mbisbano1/ECE388_CatchTheLightV2/Photos/20201203_170117.jpg

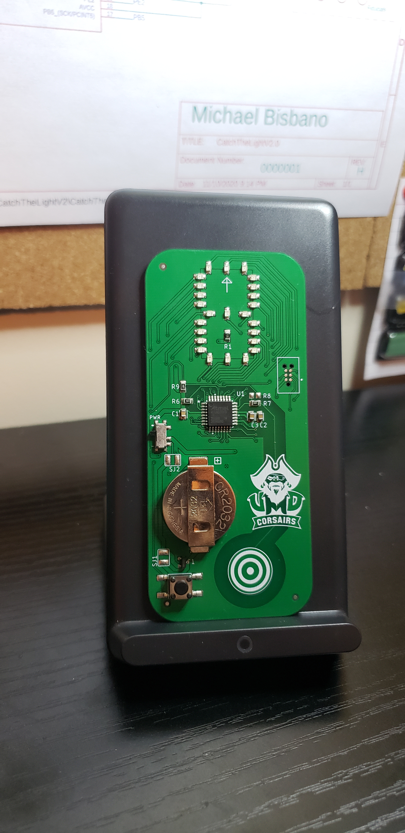
Photos/20201203_170117.jpg
