mbisbano1/ECE388_CatchTheLightV2/SilkscreenImages/umd.jpg

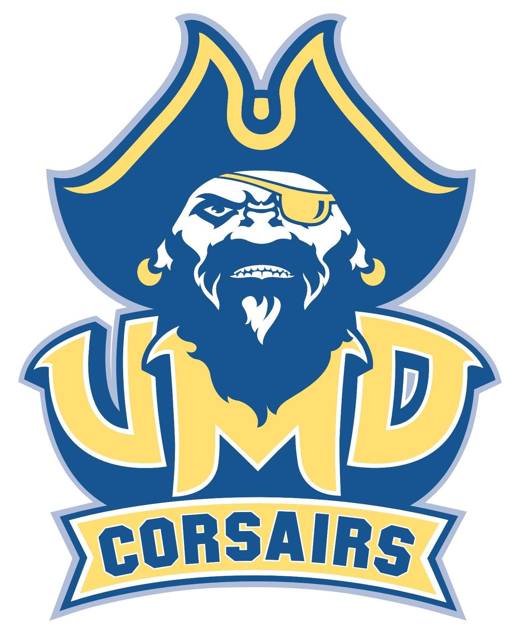
SilkscreenImages/umd.jpg
