mbisbano1/ECE388_CatchTheLightV2/README.md

# ECE388_CatchTheLightV2
Michael Bisbano's Fall 2020 ECE 388 Project: CatchTheLightV2
