mbisbano1/ECE388_CatchTheLightV2/(threads)

Thread 1 (2020-10-18):

Bom Review

timChase98, 2020-10-18:
- [x] Q-Touch button shouldn't be on the BOM
- [ ] battery holder should have the alt supplier colums filled out.

Good work, please fix these things but I'll put you down as passed.

mbisbano1, 2020-10-19:
For the price of the battery holder, I wasn't able to find it, and it isn't available on the link to it.
I have included the link to the battery holder on the BOM, but left the price blank.

I also removed the Q-touch button from the BOM as you recommended.

Closed 2020-11-07.

Thread 2 (2020-11-07):

Schematic Submission

timChase98, 2020-11-07:
- [x] While this is very organized its hard to follow.
  - [x] Try to have clear flow from left-right
  - [x] Power input top left
  - [x] Buttons input to uController
  - [x] uController outputs to LEDs
- [x] Do you have reverse voltage protection for if the user inserts a battery backwards?
- [x] Use power flags instead of named nets for power
- [x] Any time a signal leaves the section of the schematic that should be clearly indicated by a tail net. LED_ANODE is an example of this.  It should be clear that that is coming from somewhere else
- [x] The 328PB symbol doesn't need to be anywhere near that wide.
- [x] Decoupling capacitors should be located near the chip they are decoupling.  Ideally connected via a physical net, this makes it more clear what chip it belongs to when you go to do a layout.

Aside from format issue this looks really good.  Address the format issues but I will move onto board review.

Please address these issues and push your changes. Then create a new release, increment the tag and close this issue. I will review the changes and mark this as complete or reopen the issue with additional feedback.

mbisbano1, 2020-11-09:
I have tried to clear all issues posed here.

1. Added Schottky Diode Reverse voltage protection
2. Replaced net labels with Power Flags from supply1 library
3. Made Signals entering and exiting nets easier to follow by using bold label flags.
4. Narrowed the 328PB symbol..
5. Placed Decoupling capacitors physically closer to 328pb symbol to denote their proximity on board layout.
6. More organized left - right flow of information in schematic.

- Battery connection top left.
- Immediately below that is the reverse voltage protection and power switch
- Immediately below that is the current limiting resistor which 'produces' LED_ANODE voltage source.
- Flow of Button/Spare Button signal connection is more intuitive as well, which is directly connected to uController PE3 through a physical net.

NOTE:
- I left the LEDs along the top row and did not directly connect them to the 328pb symbol as the clutter from connecting all of those traces alongside with the decoupling caps would surely make the schematic unreadable.

timChase98, 2020-11-10:
Why are there resistors on the programming line? Its also called a bed of nails programmer not a plug of nails.  Fix those things and I'll give you a pass

mbisbano1, 2020-11-10:
Issues fixed as requested.

timChase98, 2020-11-11:
Change your reverse voltage protection to the one from [THIS](https://www.ti.com/lit/an/slva139/slva139.pdf) App note from TI.  That should be the last thing.

timChase98, 2020-11-11:
Yes the point of the app note is that just dropping a diode in isn't a great solution and using the NFet is much better

mbisbano1, 2020-11-11:
Schottky Diode reverse protection replaced with a PMOS protection circuit citing said app note. Reasoning for PMOS is PMOS are cheaper than NMOS by thin margin, and wiring is easier in my scenario.

Closed 2020-11-11.

Thread 3 (2020-11-07):

Board Submission

timChase98, 2020-11-07:
- [x] Review the submission guidelines [HERE](https://github.com/timChase98/388Example)
- [x] Silkscreen labels must include
  - [x] Your Name
  - [x] Project Name
  - [x] Date
  - [x] Version/Rev
  - [x] Github Link
- [x] Check stock sheet for correct footprints for
  - [x] Power Switch
  - [x] Battery Holder
- [x] Placement of fiducials should be
  - [x] FID1 lower left
  - [x] FID2 upper left
  - [x] FID3 lower right
- [x] Looks like the silkscreen for the battery holder goes over the pads.  I would also add thermal relief to the center pad-gnd plane

These are initial comments meant to guide you though the layout process.  I will not look at your board again until your schematic passes review.  This is to reduce the workload on you by limiting the number of times you need to relayout your board due to schematic errors.

Please address these issues and push your changes. Then create a new release, increment the tag and close this issue. I will review the changes and mark this as complete or reopen the issue with additional feedback.

mbisbano1, 2020-11-10:
Are you able to specify what about my submission went against the submission guidelines? I thought I followed them quite well.

timChase98, 2020-11-11:
Sorry you can ignore that.  Its from the template I used for everyone and I forgot to take it out for you

mbisbano1, 2020-11-11:
@timChase98 when/if you get a chance could you look at the footprint I made for the switch? Low priority as I have the bypass solder junction there as you recommended.

timChase98, 2020-11-11:
Is it in the current gerber files?

mbisbano1, 2020-11-11:
@timChase98 Yes, it was in the Gerber files. I was just concerned about the drills required.

timChase98, 2020-11-11:
Ya it looks good as far as I can tell

mbisbano1, 2020-11-11:
Okay, thank you.

timChase98, 2020-11-11:
You have a couple of spots where the silkscreen overlaps the pads The text SJ2 and your + and - symbols.  Everything else looks good.

mbisbano1, 2020-11-11:
Okay, I'll fix that quick. Thank you

timChase98, 2020-11-11:
Looks good.  Move onto layout

timChase98, 2020-11-11:
wrong tab ignore that

mbisbano1, 2020-11-11:
Okay, I'll fix that quick. Thank you

mbisbano1, 2020-11-11:
Issues fixed, and new Gerber Submission Release created.

timChase98, 2020-11-11:
Still an issue for T1 and SJ2 should be next to the jumper not the test points

mbisbano1, 2020-11-11:
Whoops. Thanks. I looked over every pad this time, should be good.

timChase98, 2020-11-11:
This passes, good job

mbisbano1, 2020-11-11:
Awesome, thank you

timChase98, 2020-11-16:
Your board was sent to fab

Closed 2020-11-11.
