mbisbano1/ECE388_CatchTheLightV2/schematic.pdf

A

A

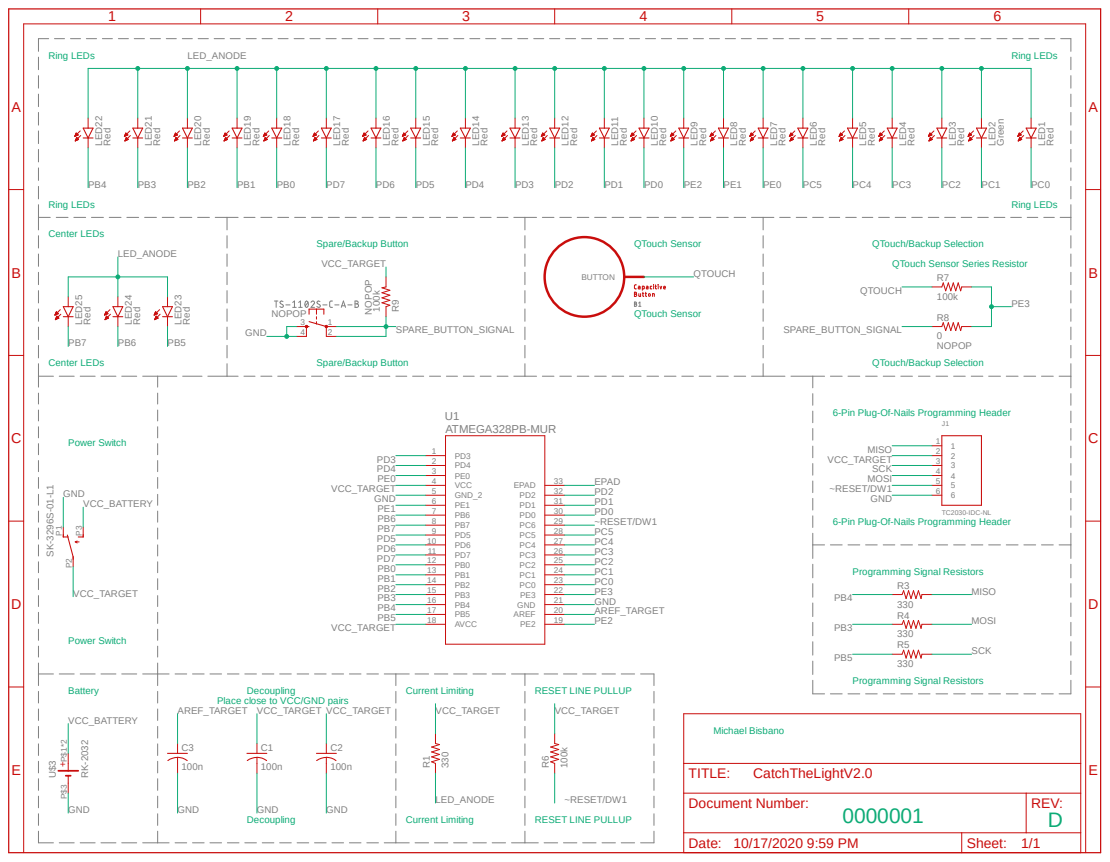
[picture p3: page 1]

LED_ANODE

QTouch/Backup Selection
QTouch Sensor Series Resistor

6-Pin Plug-Of-Nails Programming Header

Document Number: | REV:

Date: 10/17/2020 9:59 PM | Sheet: 1/1
