mbisbano1/ECE388_CatchTheLightV2/CatchTheLightV2.0.pdf

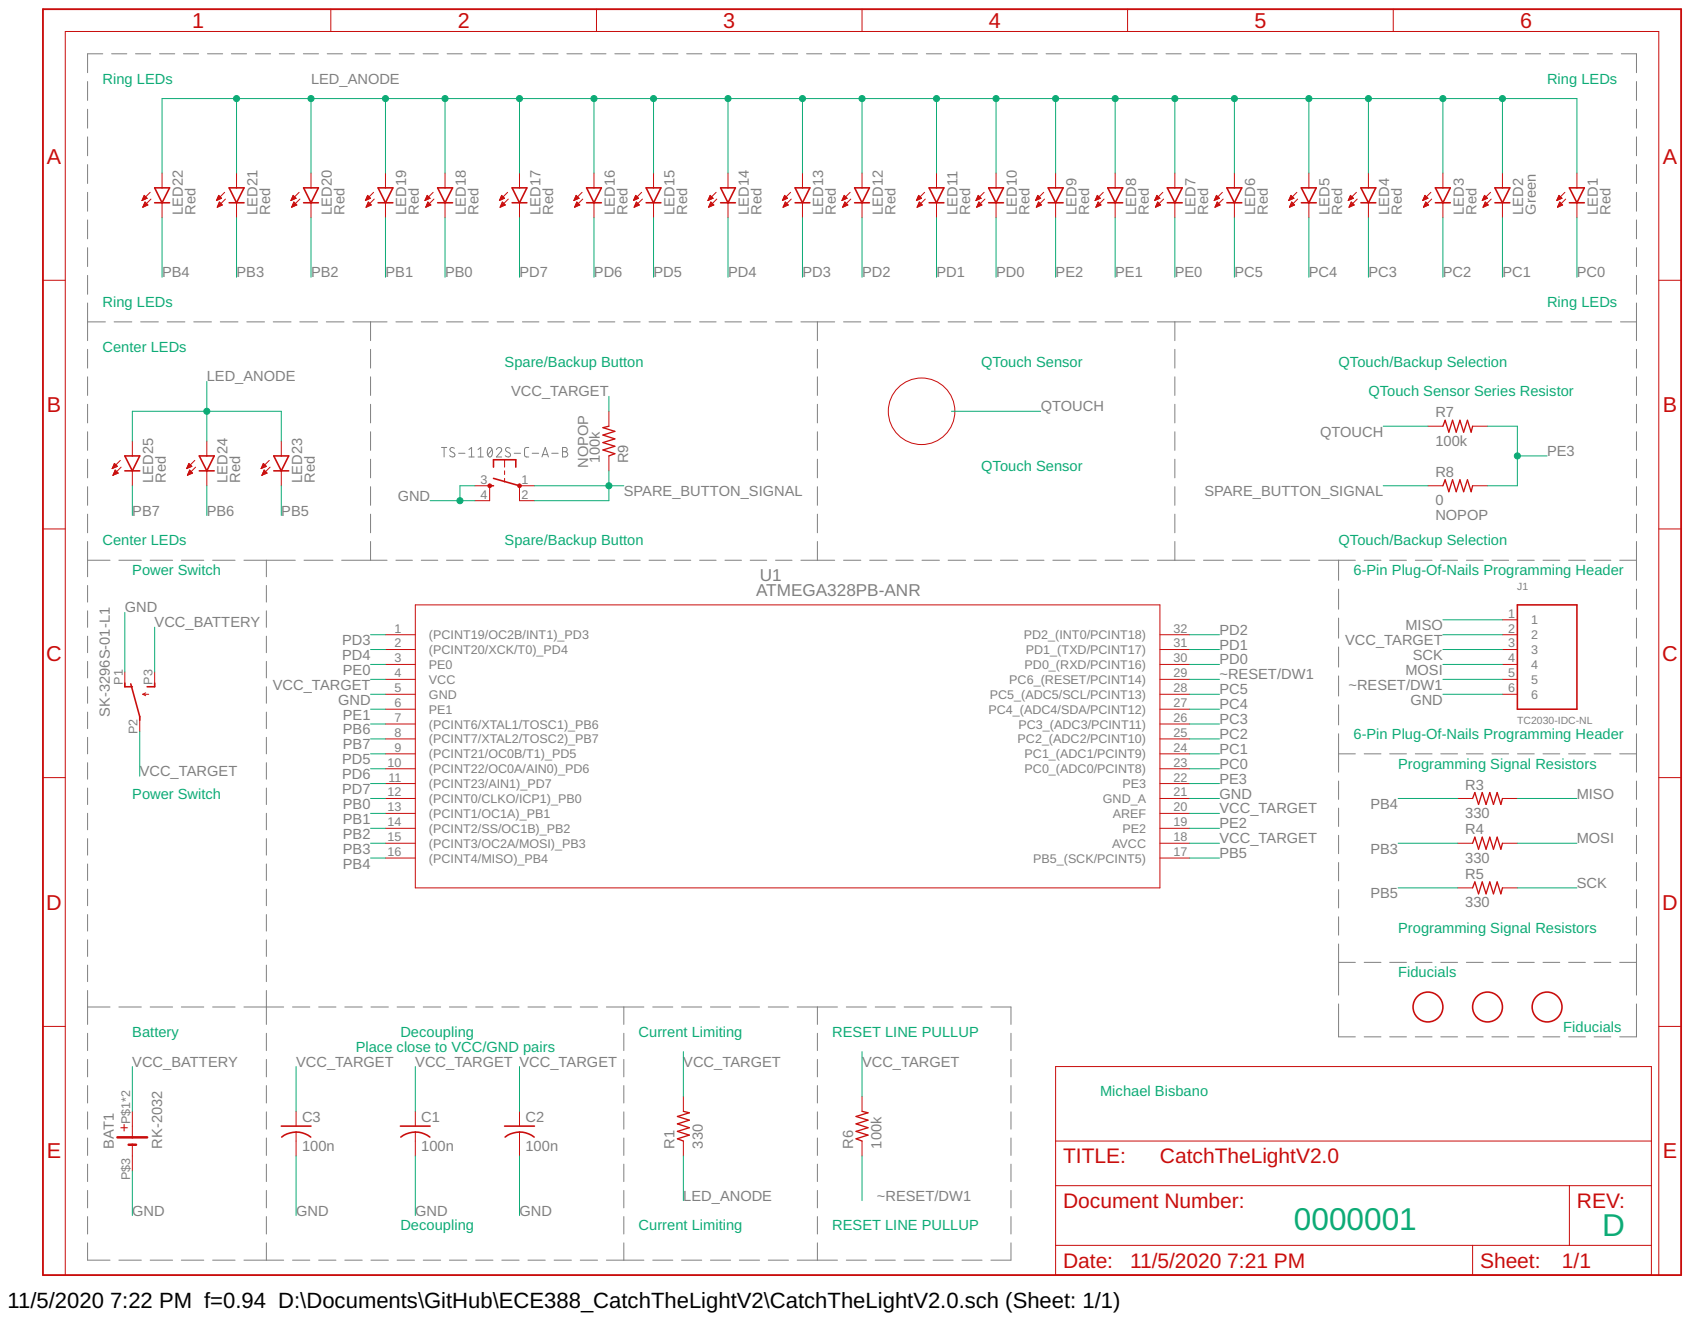
[picture p4: page 1]

Red Red Red Red Red Red Red Red Red Red Green Red

Red Red Red Red Red

Ring LEDs Center LEDs

QTouch Sensor

QTouch Sensor Series Resistor

6-Pin Plug-Of-Nails Programming Header

Place close to VCC/GND pairs Decoupling

Document Number: | REV:

Date: 11/5/2020 7:21 PM | Sheet: 1/1

11/5/2020 7:22 PM f=0.94 D:\Documents\GitHub\ECE388_CatchTheLightV2\CatchTheLightV2.0.sch (Sheet: 1/1)
