mbisbano1/ECE388_CatchTheLightV2/renders/CatchTheLightV2.0.pdf

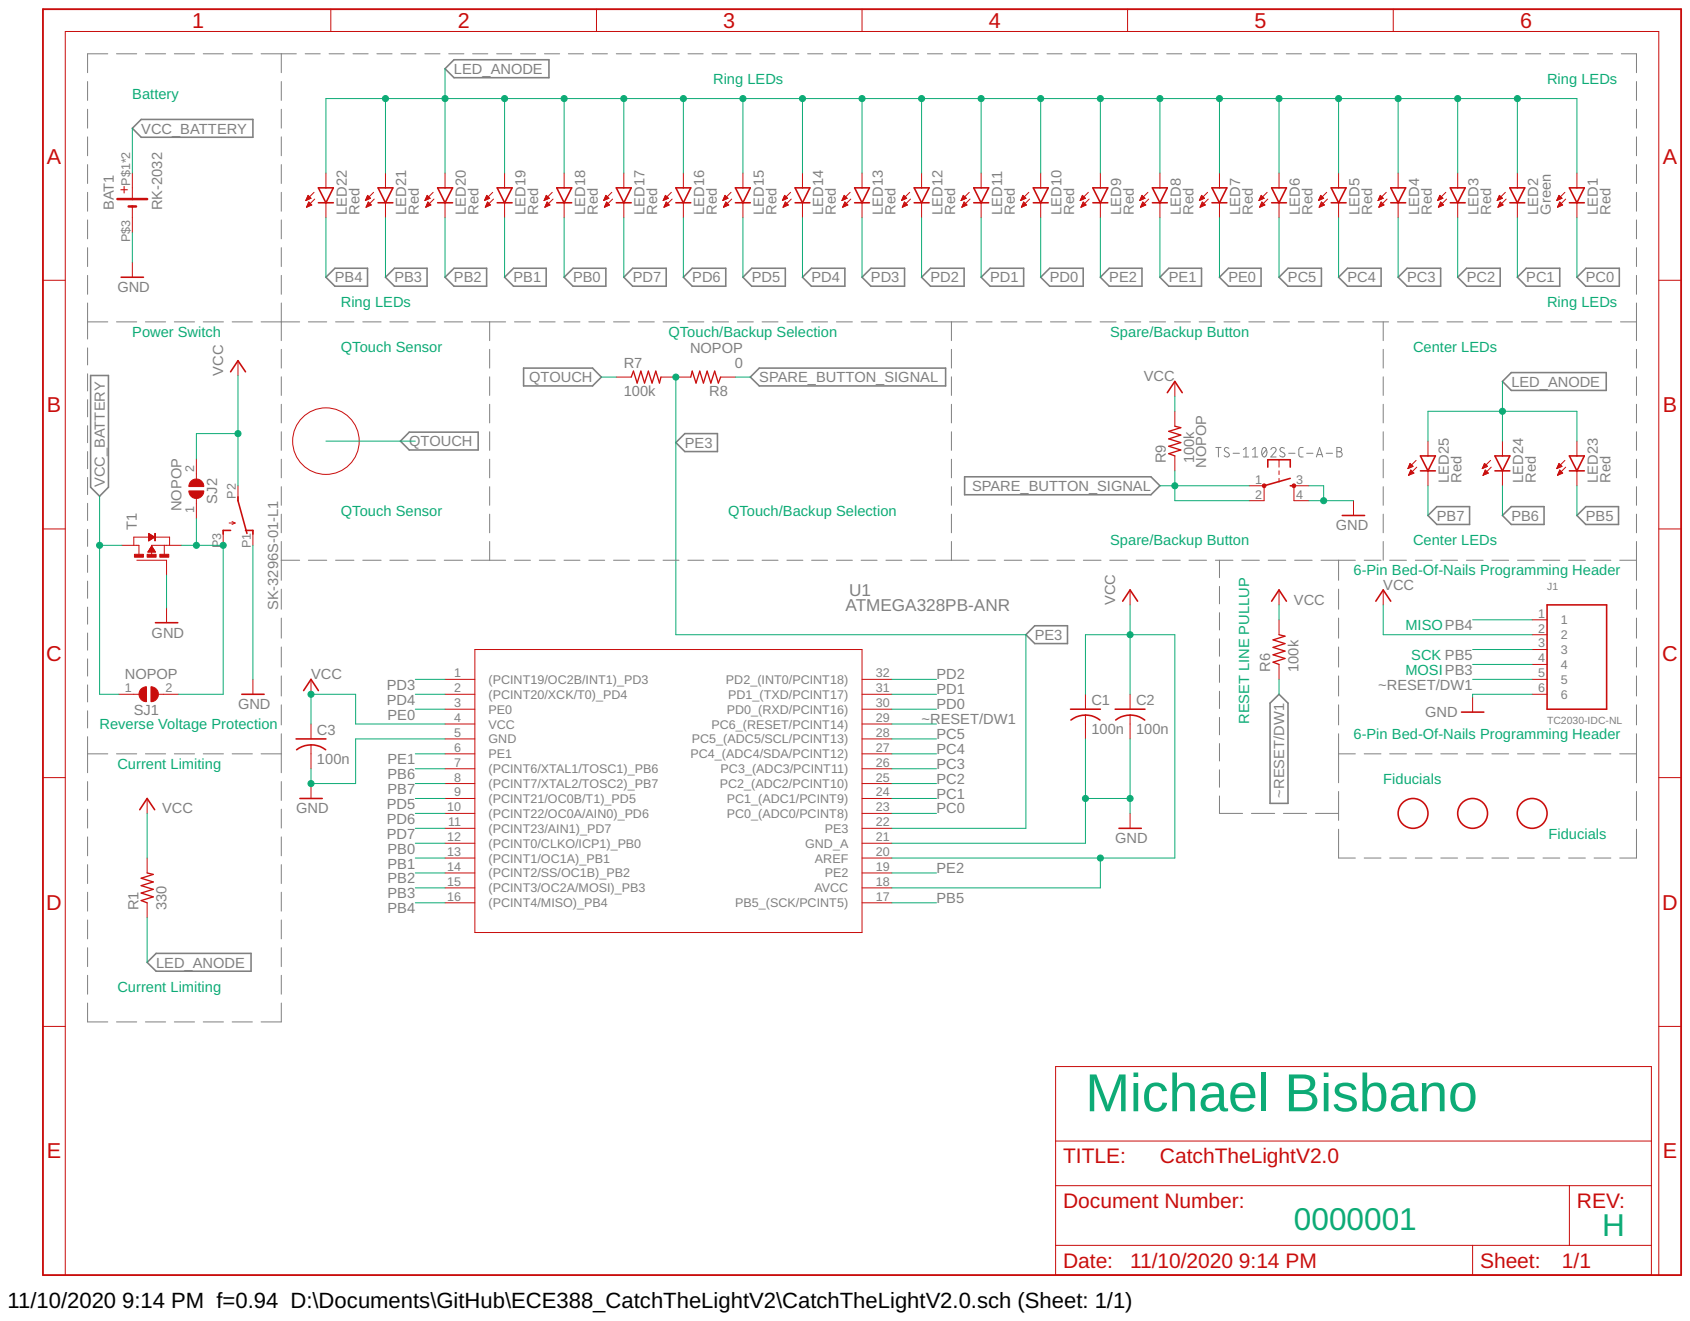
[picture p5: page 1]

Red Red Red Red Red Red Red Red Red Red Green Red Red Red Red

Red Red Red Red Red

Ring LEDs Center LEDs

6-Pin Bed-Of-Nails Programming Header

Document Number: 0000001 | REV: H

Date: 11/10/2020 9:14 PM | Sheet: 1/1

11/10/2020 9:14 PM f=0.94 D:\Documents\GitHub\ECE388_CatchTheLightV2\CatchTheLightV2.0.sch (Sheet: 1/1)
