mbisbano1/ECE388_CatchTheLightV2/CatchTheLightV2.0.brd

## EAGLE design CatchTheLightV2.0.brd (2020-11-20)

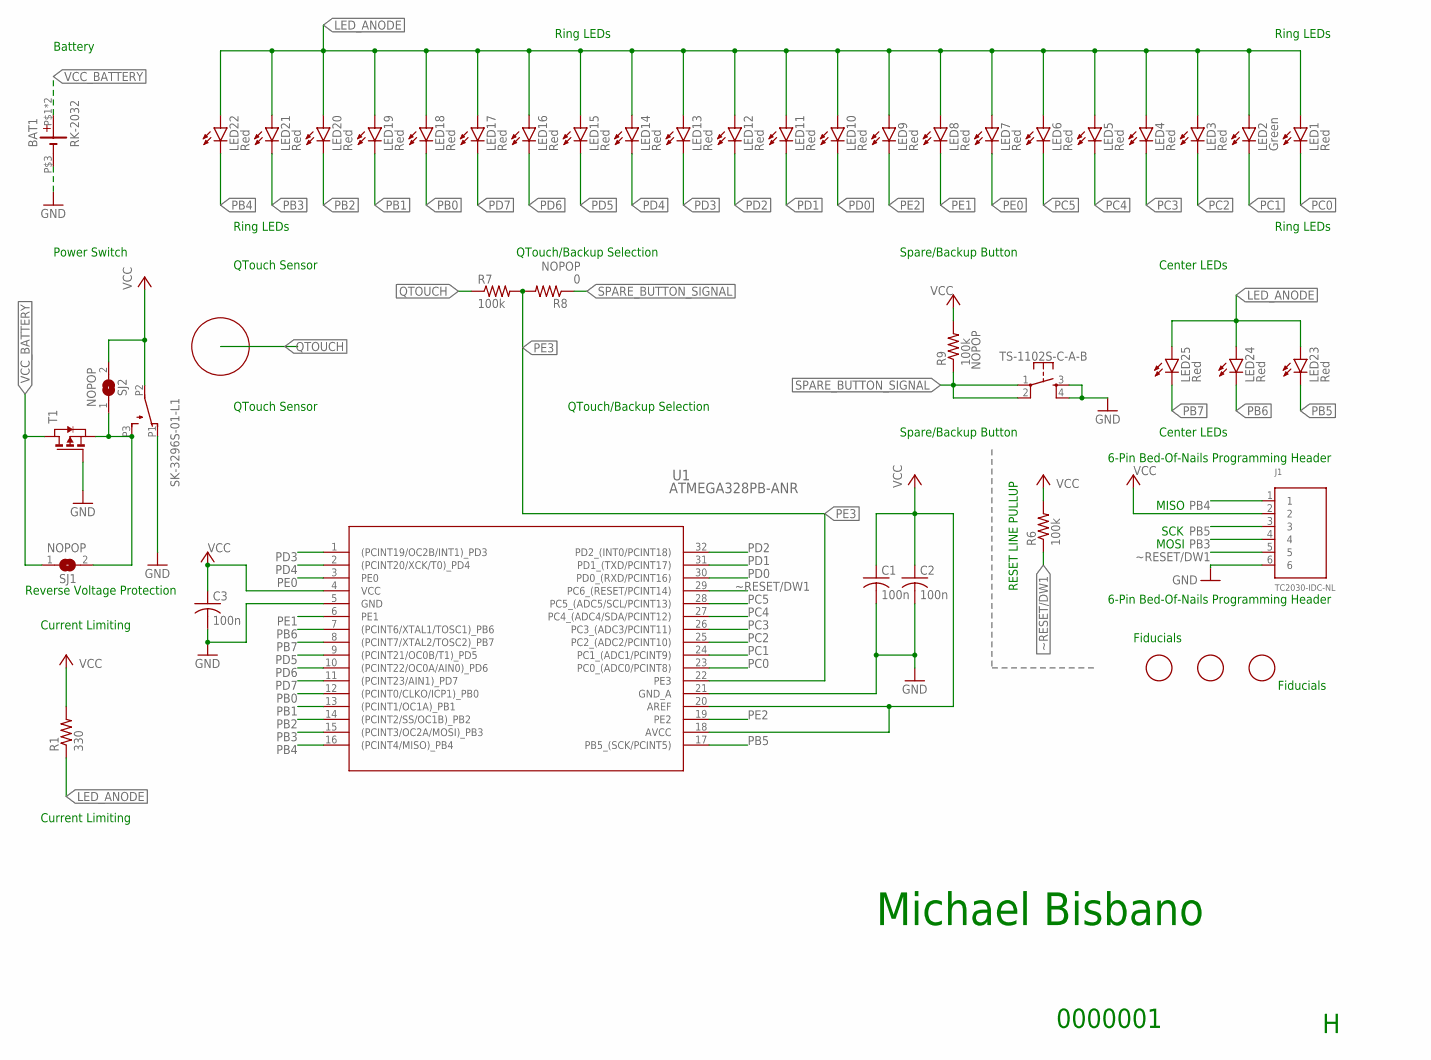
[picture p6: schematic CatchTheLightV2.0.sch]

Parts:
BAT1: RK-2032
C1, C2, C3: 100n; CAPC2012X110
J1: TC2030-IDC-NL; TAG_TC2030-IDC-NL
LED1, LED3, LED4, LED5, LED6, LED7, LED8, LED9, LED10, LED11, LED12, LED13, LED14, LED15, LED16, LED17, LED18, LED19, LED20, LED21, LED22, LED23, LED24: Red; CHIP-LED0805
LED2: Green; CHIP-LED0805
LED25: Red; CHIPLED_0805
PB1: SK-3296S-01-L1
PB2: PB2; TS-1102S-C-A-B
R1: 330; R0805
R6, R7, R9: 100k; R0805
R8: 0; R0805
SJ1, SJ2: NOPOP; SJW
T1: PMOSSOT23; SOT-23
U1: ATMEGA328PB-ANR; 32A_MCH
U$4, U$5, U$6: FIDUCIAL; FIDUCIAL_1MM

Connections:
GND: BAT1.P$3 (-), C1.2, C2.2, C3.2, J1.6, PB1.P1 (1), PB2.3, PB2.4, T1.3 (G), U1.5 (GND), U1.21 (GND_A)
LED_ANODE: LED1.A, LED2.A, LED3.A, LED4.A, LED5.A, LED6.A, LED7.A, LED8.A, LED9.A, LED10.A, LED11.A, LED12.A, LED13.A, LED14.A, LED15.A, LED16.A, LED17.A, LED18.A, LED19.A, LED20.A, LED21.A, LED22.A, LED23.A, LED24.A, LED25.A, R1.1
PB0: LED18.C, U1.12 ((PCINT0/CLKO/ICP1)_PB0)
PB1: LED19.C, U1.13 ((PCINT1/OC1A)_PB1)
PB2: LED20.C, U1.14 ((PCINT2/SS/OC1B)_PB2)
PB3: J1.4, LED21.C, U1.15 ((PCINT3/OC2A/MOSI)_PB3)
PB4: J1.1, LED22.C, U1.16 ((PCINT4/MISO)_PB4)
PB5: J1.3, LED23.C, U1.17 (PB5_(SCK/PCINT5))
PB6: LED24.C, U1.7 ((PCINT6/XTAL1/TOSC1)_PB6)
PB7: LED25.C, U1.8 ((PCINT7/XTAL2/TOSC2)_PB7)
PC0: LED1.C, U1.23 (PC0_(ADC0/PCINT8))
PC1: LED2.C, U1.24 (PC1_(ADC1/PCINT9))
PC2: LED3.C, U1.25 (PC2_(ADC2/PCINT10))
PC3: LED4.C, U1.26 (PC3_(ADC3/PCINT11))
PC4: LED5.C, U1.27 (PC4_(ADC4/SDA/PCINT12))
PC5: LED6.C, U1.28 (PC5_(ADC5/SCL/PCINT13))
PD0: LED10.C, U1.30 (PD0_(RXD/PCINT16))
PD1: LED11.C, U1.31 (PD1_(TXD/PCINT17))
PD2: LED12.C, U1.32 (PD2_(INT0/PCINT18))
PD3: LED13.C, U1.1 ((PCINT19/OC2B/INT1)_PD3)
PD4: LED14.C, U1.2 ((PCINT20/XCK/T0)_PD4)
PD5: LED15.C, U1.9 ((PCINT21/OC0B/T1)_PD5)
PD6: LED16.C, U1.10 ((PCINT22/OC0A/AIN0)_PD6)
PD7: LED17.C, U1.11 ((PCINT23/AIN1)_PD7)
PE0: LED7.C, U1.3 (PE0)
PE1: LED8.C, U1.6 (PE1)
PE2: LED9.C, U1.19 (PE2)
PE3: R7.2, R8.2, U1.22 (PE3)
PROTECTED_VBAT: PB1.P3 (3), SJ1.2, SJ2.1, T1.2 (S)
QTOUCH: R7.1
SPARE_BUTTON_SIGNAL: PB2.1, PB2.2, R8.1, R9.1
VCC: C1.1, C2.1, C3.1, J1.2, PB1.P2 (2), R1.2, R6.2, R9.2, SJ2.2, U1.4 (VCC), U1.18 (AVCC), U1.20 (AREF)
VCC_BATTERY: BAT1.P$1 (+), BAT1.P$2 (+), SJ1.1, T1.1 (D)
~RESET/DW1: J1.5, R6.1, U1.29 (PC6_(RESET/PCINT14))

Notes on the sheet:
0000001
Current Limiting
Battery
RESET LINE PULLUP
Ring LEDs
Center LEDs
Spare/Backup Button
QTouch/Backup Selection
QTouch Sensor
6-Pin Bed-Of-Nails Programming Header
Power Switch
Reverse Voltage Protection
Michael Bisbano
Fiducials
SCK
MOSI
MISO

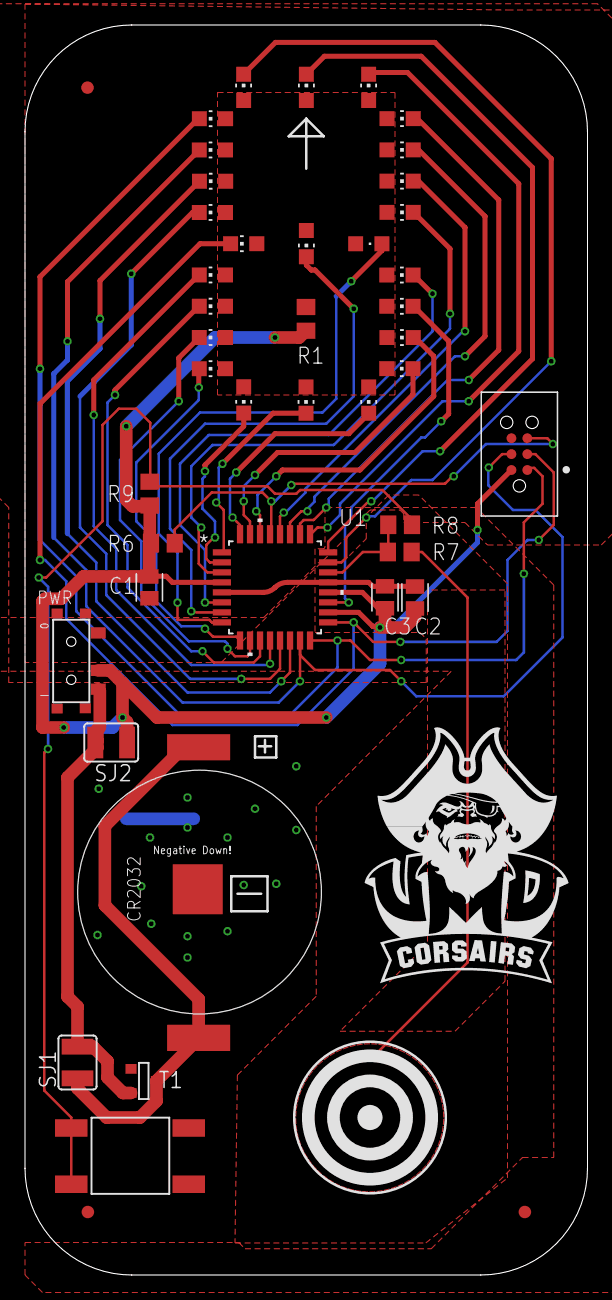
[picture p7: board CatchTheLightV2.0.brd from above]

Board: 2 copper layers, 45.0 x 100.0 mm, 44 parts (0 on the bottom side), 33 nets.
