mbisbano1/ECE388_CatchTheLightV2/software/CatchTheLightPrototypeV1/LED_Animations.h

/*
 * LED_Animations.h
 *
 * Created: 12/5/2020 6:17:45 PM
 *  Author: Michael Bisbano
 */ 


#ifndef LED_ANIMATIONS_H_
#define LED_ANIMATIONS_H_
#endif /* LED_ANIMATIONS_H_ */


#define NUMLED 25

static uint8_t curLed;

#define	BMASK  0b11111111
#define	CMASK  0b00111111
#define	DMASK  0b11111111
#define	EMASK  0b00000111
static uint8_t cScaler;
#define TARGETLED 2



static uint8_t ledMode;
#define NORMALMODE	1
#define PAUSEDMODE	2
#define DISPLAY0	3
#define DISPLAY1	4
#define DISPLAY2	5
#define DISPLAY3	6
#define DISPLAY4	7
#define DISPLAY5	8
#define DISPLAY6	9
#define DISPLAY7	10
#define DISPLAY8	11
#define DISPLAY9	12
#define LEDSOFF		13
#define NEWGAMEANIMATE 14
#define DISPLAYX	15
#if(FancyAnimations == 1)
#define G0		16
#define G1		17
#define G2		18
#define G3		19
#define G4		20
#define G5		21
#define G6		22
#define G7		23
#define G8		24
#define G9		25
#define G10		26
#endif



static uint16_t delayScaler = 0;
static uint8_t skipFlag = 0;
static uint8_t loopFlag = 0;
static uint8_t curLedWhenPressed = 0;
static uint8_t wrappedAround = 0;
static uint8_t numberPresses = 0;



//static uint8_t	LED_BANKB_TAB[] = {	0xFE,	0xFD,	0xFB,	0xF7,	0xEF,	0xDF,	0xFF,	0xFF};
const uint8_t	LED_BANKB_TAB[] = {	(BMASK&~(0b1<<0)),	(BMASK&~(0b1<<1)),	(BMASK&~(0b1<<2)),	(BMASK&~(0b1<<3)),	(BMASK&~(0b1<<4)),	(BMASK&~(0b1<<5)),	(BMASK&~(0b1<<6)),	(BMASK&~(0b1<<7))};

//static uint8_t	LED_BANKC_TAB[] = {	0xFE,	0xFD,	0xFB,	0xF7,	0xEF,	0xDF,	0xFF,	0xFF};
const uint8_t	LED_BANKC_TAB[] = {	(CMASK&~(0b1<<0)),	(CMASK&~(0b1<<1)),	(CMASK&~(0b1<<2)),	(CMASK&~(0b1<<3)),	(CMASK&~(0b1<<4)),	(CMASK&~(0b1<<5)),	(CMASK&~(0b1<<6)),	(CMASK&~(0b1<<7))};

//curLedVal							0		1		2		3		4		5		6		7
const uint8_t	LED_BANKD_TAB[] = {	(DMASK&~(0b1<<0)),	(DMASK&~(0b1<<1)),	(DMASK&~(0b1<<2)),	(DMASK&~(0b1<<3)),	(DMASK&~(0b1<<4)),	(DMASK&~(0b1<<5)),	(DMASK&~(0b1<<6)),	(DMASK&~(0b1<<7))};

//static uint8_t	LED_BANKE_TAB[] = {	0xFE,	0xFD,	0xFB,	0xF7,	0xFF,	0xFF,	0xFF,	0xFF};
const uint8_t	LED_BANKE_TAB[] = {	(EMASK&~(0b1<<0)),	(EMASK&~(0b1<<1)),	(EMASK&~(0b1<<2)),	(EMASK&~(0b1<<3)),	(EMASK&~(0b1<<4)),	(EMASK&~(0b1<<5)),	(EMASK&~(0b1<<6)),	(EMASK&~(0b1<<7))};


void ledIntSetup(void)
{
	OCR2B = 0xFF;				//Set Timer 0 INT B Compare Register value.
}

void ledIntEnable(void)
{
	TIMSK0 |= (0b1<<OCIE0B);	//Enable Timer 0 INT B
}

void ledIntDisable(void)
{
	TIMSK0 &= ~(0b1<<OCIE0B);	//Disable Timer 0 INT B
}

void ClearLed(void)
{
	PORTD |= DMASK;
	PORTB |= BMASK;
	PORTC |= CMASK;
	PORTE |= EMASK;
}

void NextLedReverse(void)
{
	if(6 > curLed)
	{
		PORTB = BMASK;
		PORTC = CMASK&LED_BANKC_TAB[curLed];
		PORTD = DMASK;
		PORTE = EMASK;
	}
	if( (9 > curLed) && (6 <= curLed))	// 8 + 6
	{
		PORTB = BMASK;
		PORTC = CMASK;
		PORTD = DMASK;
		PORTE = EMASK&LED_BANKE_TAB[curLed - 6];
	}
	if( (17 > curLed) && (9 <= curLed))
	{
		PORTB = BMASK;
		PORTC = CMASK;
		PORTD = DMASK&LED_BANKD_TAB[curLed - 9];
		PORTE = EMASK;
	}
	if( (25 > curLed) && (17 <= curLed))
	{
		PORTB = BMASK&LED_BANKB_TAB[curLed - 17];
		PORTC = CMASK;
		PORTD = DMASK;
		PORTE = EMASK;
	}
	curLed -= 1;
	if(21 < curLed)
	{
		curLed = 21;
	}
	if(curLed == ((curLedWhenPressed+20)%22))
	{
		loopFlag = 0;
	}
}


void NextLed(void)
{
	if(6 > curLed)
	{
		PORTB = BMASK;
		PORTC = CMASK&LED_BANKC_TAB[curLed];
		PORTD = DMASK;
		PORTE = EMASK;
	}
	if( (9 > curLed) && (6 <= curLed))	// 8 + 6
	{
		PORTB = BMASK;
		PORTC = CMASK;
		PORTD = DMASK;
		PORTE = EMASK&LED_BANKE_TAB[curLed - 6];
	}
	if( (17 > curLed) && (9 <= curLed))
	{
		PORTB = BMASK;
		PORTC = CMASK;
		PORTD = DMASK&LED_BANKD_TAB[curLed - 9];
		PORTE = EMASK;
	}
	if( (25 > curLed) && (17 <= curLed))
	{
		PORTB = BMASK&LED_BANKB_TAB[curLed - 17];
		PORTC = CMASK;
		PORTD = DMASK;
		PORTE = EMASK;
	}
	curLed = ((curLed + 1)%22);
	if(curLed == ((curLedWhenPressed+2)%22))
	{
		loopFlag = 0;
	}
	//if(curLed == 0)
	//curLed = ((curLed + 1)%NUMLED);// + ((curLed + 1)/NUMLED);
}



// Segments A - G
//	A: D1 - D3
//	B: D4 - D7
//	C: D8 -D11
//	D: D12-D14
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
	{
		PORTB = BMASK&LED_BANKB_TAB[curLed - 17];
		PORTC = CMASK;
		PORTD = DMASK;
		PORTE = EMASK;
	}
	curLed -= 1;
	if(curLed > 22)
	{
		curLed = 21;
		wrappedAround++;
		
	}
	if((curLed == 1))// && wrappedAround)
	{
		ledMode = NORMALMODE;
		curLedWhenPressed = 1;
		loopFlag = 1;
	}
}

void NewGameAnimation(void)			// basically backwards NextLed() function!
{
	//curLed = 0;
	ClearLed();
	
	#if(FancyAnimations == 1)
	FillFromBottom();
	curLed = 13;
	ledMode = NEWGAMEANIMATE;
	#endif
	
	#if(FancyAnimations == 0)
	ledMode = NEWGAMEANIMATE;
	#endif
	//ledMode = NEWGAMEANIMATE;
}
