mbisbano1/ECE388_CatchTheLightV2/software/CatchTheLightPrototypeV1/include/atmel_start_pins.h

/*
 * Code generated from Atmel Start.
 *
 * This file will be overwritten when reconfiguring your Atmel Start project.
 * Please copy examples or other code you want to keep to a separate file
 * to avoid losing it when reconfiguring.
 */
#ifndef ATMEL_START_PINS_H_INCLUDED
#define ATMEL_START_PINS_H_INCLUDED

#include <port.h>

/**
 * \brief Set LED pull mode
 *
 * Configure pin to pull up, down or disable pull mode, supported pull
 * modes are defined by device used
 *
 * \param[in] pull_mode Pin pull mode
 */
static inline void LED_set_pull_mode(const enum port_pull_mode pull_mode)
{
	PORTB_set_pin_pull_mode(5, pull_mode);
}

/**
 * \brief Set LED data direction
 *
 * Select if the pin data direction is input, output or disabled.
 * If disabled state is not possible, this function throws an assert.
 *
 * \param[in] direction PORT_DIR_IN  = Data direction in
 *                      PORT_DIR_OUT = Data direction out
 *                      PORT_DIR_OFF = Disables the pin
 *                      (low power state)
 */
static inline void LED_set_dir(const enum port_dir dir)
{
	PORTB_set_pin_dir(5, dir);
}

/**
 * \brief Set LED level
 *
 * Sets output level on a pin
 *
 * \param[in] level true  = Pin level set to "high" state
 *                  false = Pin level set to "low" state
 */
static inline void LED_set_level(const bool level)
{
	PORTB_set_pin_level(5, level);
}

/**
 * \brief Toggle output level on LED
 *
 * Toggle the pin level
 */
static inline void LED_toggle_level()
{
	PORTB_toggle_pin_level(5);
}

/**
 * \brief Get level on LED
 *
 * Reads the level on a pin
 */
static inline bool LED_get_level()
{
	return PORTB_get_pin_level(5);
}

/**
 * \brief Set PE3 pull mode
 *
 * Configure pin to pull up, down or disable pull mode, supported pull
 * modes are defined by device used
 *
 * \param[in] pull_mode Pin pull mode
 */
static inline void PE3_set_pull_mode(const enum port_pull_mode pull_mode)
{
	PORTE_set_pin_pull_mode(3, pull_mode);
}

/**
 * \brief Set PE3 data direction
 *
 * Select if the pin data direction is input, output or disabled.
 * If disabled state is not possible, this function throws an assert.
 *
 * \param[in] direction PORT_DIR_IN  = Data direction in
 *                      PORT_DIR_OUT = Data direction out
 *                      PORT_DIR_OFF = Disables the pin
 *                      (low power state)
 */
static inline void PE3_set_dir(const enum port_dir dir)
{
	PORTE_set_pin_dir(3, dir);
}

/**
 * \brief Set PE3 level
 *
 * Sets output level on a pin
 *
 * \param[in] level true  = Pin level set to "high" state
 *                  false = Pin level set to "low" state
 */
static inline void PE3_set_level(const bool level)
{
	PORTE_set_pin_level(3, level);
}

/**
 * \brief Toggle output level on PE3
 *
 * Toggle the pin level
 */
static inline void PE3_toggle_level()
{
	PORTE_toggle_pin_level(3);
}

/**
 * \brief Get level on PE3
 *
 * Reads the level on a pin
 */
static inline bool PE3_get_level()
{
	return PORTE_get_pin_level(3);
}

#endif /* ATMEL_START_PINS_H_INCLUDED */
