mbisbano1/ECE388_CatchTheLightV2/(commit log)

2020-10-12 First Commit of files
    Added base version of software, and unfinished schematic
    [CatchTheLightV2.0.csv, CatchTheLightV2.0.sch]
2020-10-12 Fixed BOM
    BOM was reformatted to meet expectations.
    [CatchTheLightV2.0.csv, FormalBom1.xlsx]
2020-10-14 Revised BOM
    Added Tolerances and Rating column in for passives
    [CatchTheLightV2.0.csv, CatchTheLightV2.0.xlsx]
2020-10-14 Delete CatchTheLightV2.0.xlsx
    xlsx file not needed for submission, .csv file is saved instead
    [CatchTheLightV2.0.xlsx]
2020-10-14 Delete FormalBom1.xlsx
    backup of old BOM, not needed for submission
    [FormalBom1.xlsx]
2020-10-15 Update CatchTheLightV2.0.sch
    modified Schematic to add features
    [CatchTheLightV2.0.sch]
2020-10-16 Update CatchTheLightV2.0.sch
    Created CustomParts.lbr for backup push button and power switch components, implemented them into schematic.
    [CatchTheLightV2.0.sch]
2020-10-16 Replaced Old Switch and Button components
    New Library components added, in process of modifying bom
    [CatchTheLightV2.0.sch, CatchTheLightV2.xlsx, CatchTheLightV2_New.csv]
2020-10-17 Finalized BOM
    New values and components included
    [CatchTheLightV2.0.csv, CatchTheLightV2.xlsx, CatchTheLightV2_New.csv]
2020-10-17 Updated Battery Holder
    Battery holder updated in schematic, Custom Parts Library, and in BOM. Price not included in BOM for Battery holder as we cannot find it online
    [CatchTheLightV2.0.csv, CatchTheLightV2.0.sch, CatchTheLightV2.xlsx]
2020-10-19 Final fixes to BOM
    Final fixes to BOM made.
    Also started laying out board.
    [CatchTheLightV2.0.brd, CatchTheLightV2.0.csv, CatchTheLightV2.0.sch, CatchTheLightV2.xlsx]
2020-10-23 Finished development of 7Seg LED test code
2020-11-03 Revised Schematic and Board design to use correct 328pb footprint
    Modified a whole lot. New approach to board design. Will try to fill in all wiring first, and then draw in the rest of the pours/planes
    [CatchTheLightV2.0.brd, CatchTheLightV2.0.sch]
2020-11-03 Finished Routing V1
    Routing finished, no gnd planes yet
    [CatchTheLightV2.0.brd]
2020-11-06 Schematic pdf updated and put in renders
    [CatchTheLightV2.0.brd, CatchTheLightV2.0.sch]
2020-11-06 Board V1
    First crack at board. Nervous about trace width for dissipating too much power. Also VERY unsure of qtouch button layout and traces.. We will see, will likely be modifying as the week goes on.
    [CatchTheLightV2.0.GBL, CatchTheLightV2.0.GBO, CatchTheLightV2.0.GBP, CatchTheLightV2.0.GBS, CatchTheLightV2.0.GKO, CatchTheLightV2.0.GTL, CatchTheLightV2.0.GTO, CatchTheLightV2.0.GTP]
2020-11-09 Schematic Submission Issues addressed
    Changes documented in issue
    [CatchTheLightV2.0.brd, CatchTheLightV2.0.sch]
2020-11-09 whoops forgot pdf of schematic
2020-11-09 Board Updated to meet some issue requirements
    Fiducials relocated according to spec
    Silkscreen labels updated
    Silkscreen over battery pads removed. Thermal Relief restored on GND pad.
    [CatchTheLightV2.0.brd]
2020-11-10 Removed Programming line resistors
    Removed programming line resistors and renamed plug of nails to bed of nails.
    [CatchTheLightV2.0.brd, CatchTheLightV2.0.sch]
2020-11-11 PMOS Reverse Protection in Schematic and Board
    Swapped in PMOS over Schottky diode for reverse protection
    [CatchTheLightV2.0.brd, CatchTheLightV2.0.sch]
2020-11-11 Gerber Files Updated with Board design
    [CatchTheLightV2.0.brd, CatchTheLightV2.0.csv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]
2020-11-11 Slight Changes/Optimizations on board
    [CatchTheLightV2.0.brd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]
2020-11-11 Moved switch in from edge of board for more clearance
    [CatchTheLightV2.0.brd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]
2020-11-11 Revised to fix issues
    Silk screen removed from top of pads for Switch and for Battery holder
    [CatchTheLightV2.0.brd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]
2020-11-11 Silk Screen Modified
    Silk Screen Modified, Should be last edit necessary.
    [CatchTheLightV2.0.brd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]
2020-11-12 UMD Logo Added
    Snazzy
    [CatchTheLightV2.0.brd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]
2020-11-20 Added Assembly CSV
    Assembly CSV is available. Located in root, titled CatchTheLightV2_assembly.csv
    [CatchTheLightV2.0.brd, CatchTheLightV2_assembly.csv]
2020-12-03 Code Working, still ironing out tiny bugs
    Working Code
    Also submitting photos and videos of board working
    [main.c]
2020-12-05 Green Light Hold Bug Fix
    Green Light Hold fixed:
    - Removed offending delayScaler++ from within X code in ISR.
    [main.c]
2020-12-06 Added features
    - Increase speed when correct
    - Direction tricking (switch directions randomly)..
    - Fancy animations
    [GameSettings.h, ISR_SwitchCase.h, LED_Animations.h, main.c]
