mbisbano1/ECE388_CatchTheLightV2/(notices)

Notices in the files:
parts and their libraries:
ECE_388_CustomParts_V1.1: COPYRIGHT: Copyright (C) 2018 Accelerated Designs. All rights reserved
